MissouriMRDT/RemoteController_Hardware/Documentation/PDR/PDR_Controller_PCB.png

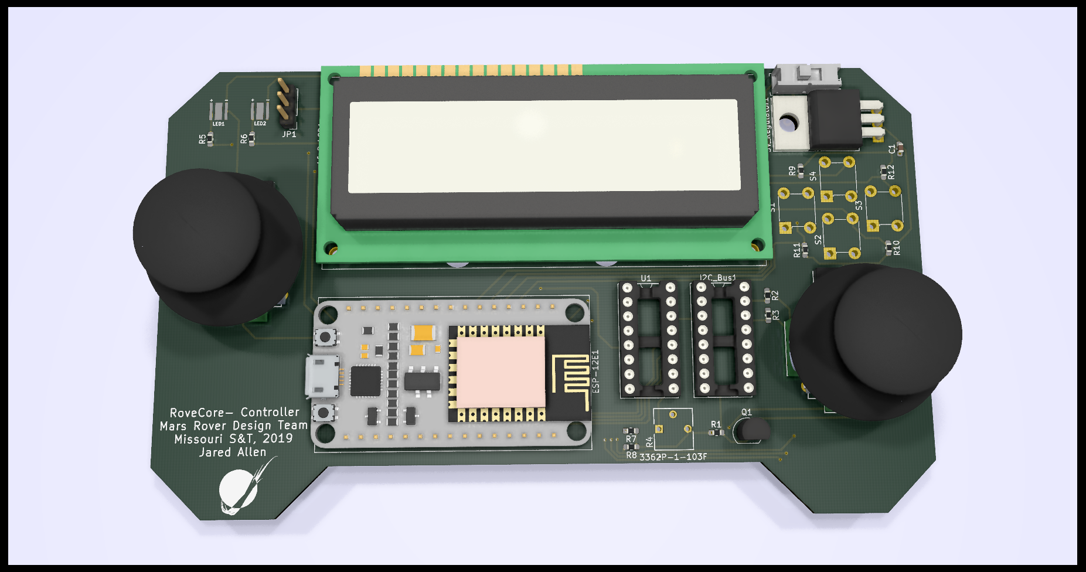
Documentation/PDR/PDR_Controller_PCB.png
