MissouriMRDT/RemoteController_Hardware/README.md

# RemoteController_Hardware
A Hardware Remote Control to drive the rover and perform other functions
