MissouriMRDT/RemoteController_Hardware/Documentation/PDR/PDR_Controller_Schematic.PNG

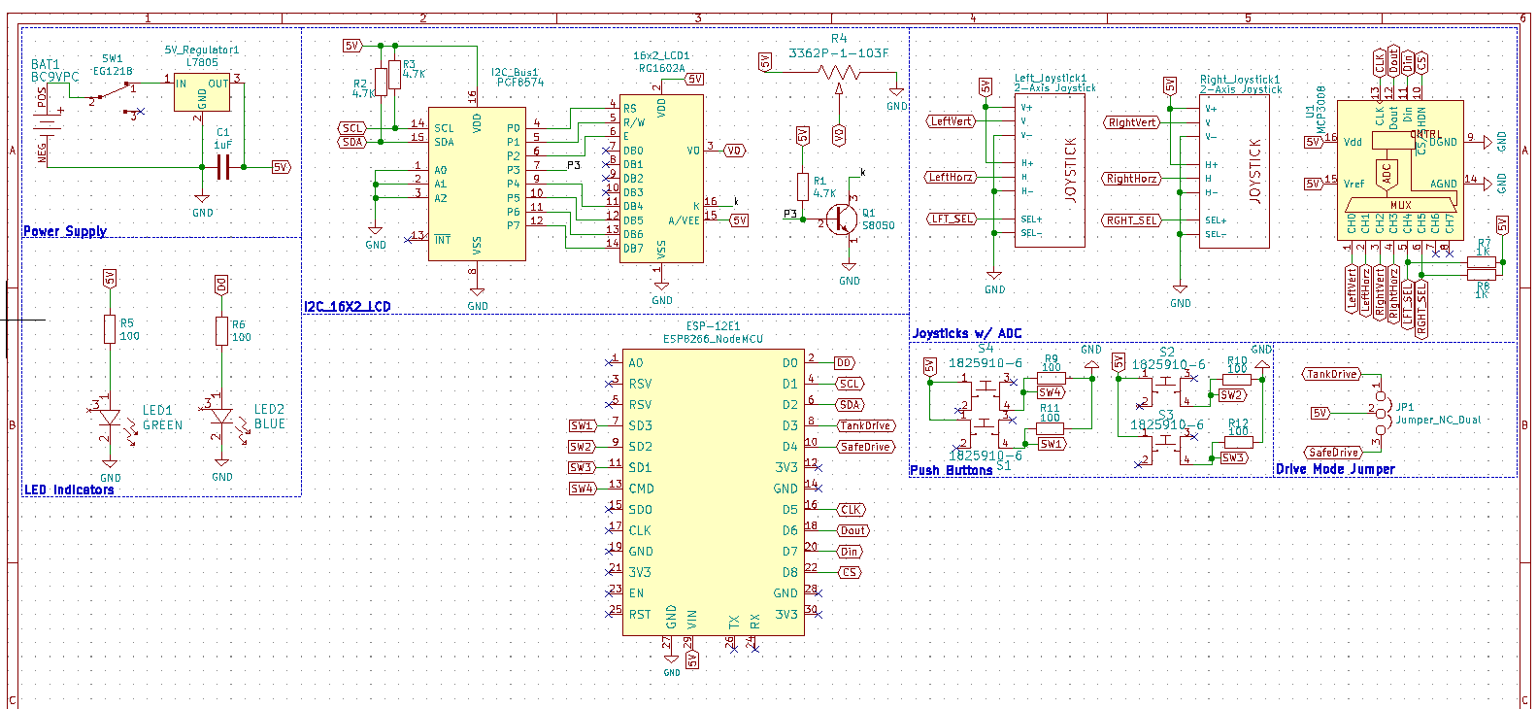
Documentation/PDR/PDR_Controller_Schematic.PNG
