MissouriMRDT/RemoteController_Hardware/Documentation/PDR/PDR_Controller_TraceView.PNG

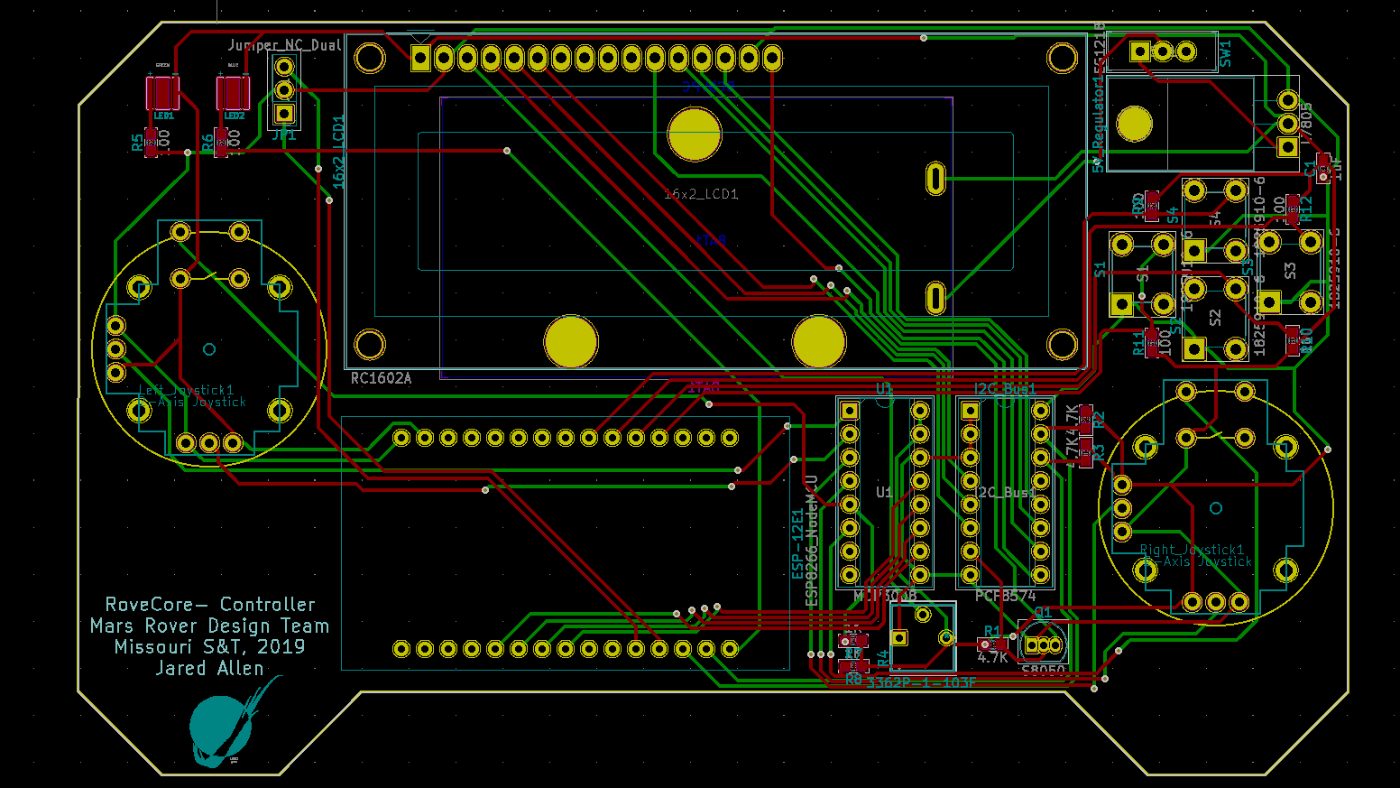
Documentation/PDR/PDR_Controller_TraceView.PNG
