MissouriMRDT/RemoteController_Hardware/Documentation/Signature_Jared_Allen.bmp

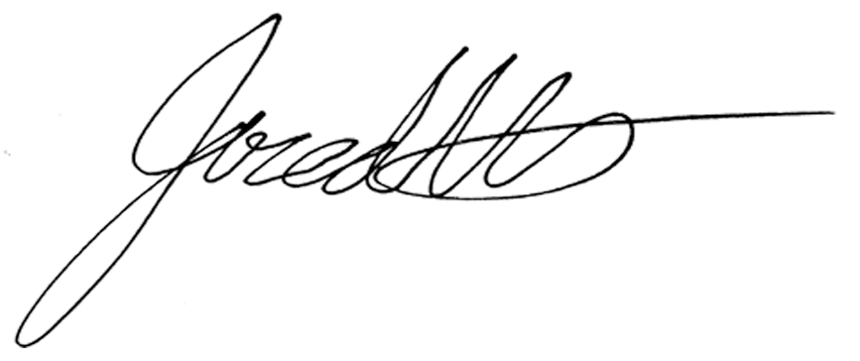
Documentation/Signature_Jared_Allen.bmp
