MissouriMRDT/RemoteController_Hardware/Rover_Controller/Rover_Controller_BOM.xlsx

Id | Designator | Package | Quantity | Designation | Item Name | Part Number | Vendor | Cost Per Item | Cost | URL | Comments | Quantity
1 | R10,R7,R8,R12,R11,R9,R13,R14 | R_0603_1608Metric_Pad1.05x0.95mm_HandSolder | 8 | 10K |  |  |  |  |  |  |  |  | Total Cost
2 | BT1 | Battery_Holder_9V_BC9VPC-ND | 1 | 9V_BAT |  |  |  |  |  |  |  |  | $0.000
3 | R6,R5,R4 | R_0603_1608Metric_Pad1.05x0.95mm_HandSolder | 3 | 510
4 | I2C_Bus1 | SOIC-16W_7.5x10.3mm_P1.27mm | 1 | PCF8574
5 | R1,R2,R3 | R_0603_1608Metric_Pad1.05x0.95mm_HandSolder | 3 | 4.7K
6 | C2,C1 | C_0603_1608Metric_Pad1.05x0.95mm_HandSolder | 2 | 1uF
7 | ADC1 | SOIC-16_3.9x9.9mm_P1.27mm | 1 | MCP3008
8 | COM1 | LED_0603_1608Metric_Pad1.05x0.95mm_HandSolder | 1 | BLUE
9 | TANK1 | LED_0603_1608Metric_Pad1.05x0.95mm_HandSolder | 1 | RED
10 | JP1 | PinHeader_1x03_P2.54mm_Vertical | 1 | Jumper_NC_Dual
11 | 16x2_LCD1 | WC1602A | 1 | RC1602A
12 | JOY2 | JOYSTICK | 1 | RIGHT_JOY
13 | Q1 | TO-92_Inline | 1 | S8050
14 | JOY1 | JOYSTICK | 1 | LEFT_JOY
15 | ESP-12E1 | ESP8266_nodeMCU | 1 | ESP8266_NodeMCU
16 | PWR1 | LED_0603_1608Metric_Pad1.05x0.95mm_HandSolder | 1 | GREEN
17 | RV1 | 3362P-1-103LF | 1 | R_POT_TRIM_10K
18 | SW1,SW2,SW3,SW4 | SW_SPST_TL3305A | 4 | SW_Push
19 | PWR_SW1 | SW_CuK_OS102011MA1QN1_SPDT_Angled | 1 | SW_SPDT
20 | 5V_Reg_1 | TO-252-2 | 1 | L7805
