MissouriMRDT/RemoteController_Hardware/Documentation/Rover_Controller_BOM.xlsx

Id | Designator | Package | Quantity | Designation | Item Name | Part Number | Vendor | Cost Per Item | Cost | URL | Comments | Quantity
1 | R10,R7,R8,R12,R11,R9,R13,R14 | R_0603_1608Metric_Pad1.05x0.95mm_HandSolder | 8 | 10K | ESR03EZPF1002 | RHM10KADCT-ND | Digikey | $0.130 | $1.040 | https://www.digikey.com/product-detail/en/rohm-semiconductor/ESR03EZPF1002/RHM10KADCT-ND/1983753 |  | 8 | Total Cost
2 | BT1 | Battery_Holder_9V_BC9VPC-ND | 1 | 9V_BAT | BC9VPC | BC9VPC-ND | Digikey | $1.980 | $1.980 | https://www.digikey.com/product-detail/en/mpd-memory-protection-devices/BC9VPC/BC9VPC-ND/257747 |  | 1 | $57.020
3 | R6,R5,R4 | R_0603_1608Metric_Pad1.05x0.95mm_HandSolder | 3 | 510 | ESR03EZPJ511 | RHM510DCT-ND | Digikey | $0.100 | $0.300 | https://www.digikey.com/product-detail/en/rohm-semiconductor/ESR03EZPJ511/RHM510DCT-ND/1762937 |  | 3
4 | I2C_Bus1 | SOIC-16W_7.5x10.3mm_P1.27mm | 1 | PCF8574 | PCF8574ADWR | 296-13105-1-ND | Digikey | $1.320 | $1.320 | https://www.digikey.com/product-detail/en/texas-instruments/PCF8574ADWR/296-13105-1-ND/484468 |  | 1
5 | R1,R2,R3 | R_0603_1608Metric_Pad1.05x0.95mm_HandSolder | 3 | 4.7K | ESR03EZPJ472 | RHM4.7KDCT-ND | Digkey | $0.100 | $0.300 | https://www.digikey.com/products/en?keywords=RHM4.7KDCT-ND |  | 3
6 | C2,C1 | C_0603_1608Metric_Pad1.05x0.95mm_HandSolder | 2 | 1uF | CL10B105MO8NNWC | 1276-6524-1-ND | Digikey | $0.100 | $0.200 | https://www.digikey.com/product-detail/en/samsung-electro-mechanics/CL10B105MO8NNWC/1276-6524-1-ND/5961383 |  | 2
7 | ADC1 | SOIC-16_3.9x9.9mm_P1.27mm | 1 | MCP3008 | MCP3008-I/SL | MCP3008-I/SL-ND | Digikey | $2.190 | $2.190 | https://www.digikey.com/product-detail/en/microchip-technology/MCP3008-I-SL/MCP3008-I-SL-ND/319423 |  | 1
8 | COM1 | LED_0603_1608Metric_Pad1.05x0.95mm_HandSolder | 1 | BLUE | LTST-C191TBKT | 160-1647-1-ND | Digikey | $0.500 | $0.500 | https://www.digikey.com/product-detail/en/lite-on-inc/LTST-C191TBKT/160-1647-1-ND/573587 |  | 1
9 | TANK1 | LED_0603_1608Metric_Pad1.05x0.95mm_HandSolder | 1 | RED | LTST-C19KRKT | 160-1447-1-ND | Digikey | $0.280 | $0.280 | https://www.digikey.com/product-detail/en/lite-on-inc/LTST-C191KRKT/160-1447-1-ND/386836 |  | 1
10 | JP1 | PinHeader_1x03_P2.54mm_Vertical | 1 | Jumper_NC_Dual | 61300311121 | 732-5316-ND | Digikey | $0.130 | $0.130 | https://www.digikey.com/product-detail/en/w-rth-elektronik/61300311121/732-5316-ND/4846825 |  | 1
11 | 16x2_LCD1 | WC1602A | 1 | RC1602A | LCR-U01602DSF/AWH | 67-2091-ND | Digikey | $18.510 | $18.510 | https://www.digikey.com/product-detail/en/lumex-opto-components-inc/LCR-U01602DSF-AWH/67-2091-ND/2237961 |  | 1
12 | JOY2 | JOYSTICK | 1 | RIGHT_JOY | COM-09032 | 1568-1526-ND | Digikey | $3.950 | $3.950 | https://www.digikey.com/product-detail/en/sparkfun-electronics/COM-09032/1568-1526-ND/6823623 |  | 1
13 | Q1 | TO-92_Inline | 1 | S8050 | SS8050DTA | SS8050DTACT-ND | Digikey | $0.280 | $0.280 | https://www.digikey.com/product-detail/en/on-semiconductor/SS8050DTA/SS8050DTACT-ND/4213850 |  | 1
14 | JOY1 | JOYSTICK | 1 | LEFT_JOY | COM-09032 | 1568-1526-ND | Digikey | $3.950 | $3.950 | https://www.digikey.com/product-detail/en/sparkfun-electronics/COM-09032/1568-1526-ND/6823623 |  | 1
15 | ESP-12E1 | ESP8266_nodeMCU | 1 | ESP8266_NodeMCU | 3046 | 1528-1901-ND | Digikey | $18.950 | $18.950 | https://www.digikey.com/product-detail/en/adafruit-industries-llc/3046/1528-1901-ND/6674211 |  | 1
16 | PWR1 | LED_0603_1608Metric_Pad1.05x0.95mm_HandSolder | 1 | GREEN | LTST-C191KGKT | 160-1446-1-ND | Digikey | $0.280 | $0.280 | https://www.digikey.com/product-detail/en/lite-on-inc/LTST-C191KGKT/160-1446-1-ND/386834 |  | 1
17 | RV1 | 3362P-1-103LF | 1 | R_POT_TRIM_10K | 3362P-1-103LF | 3362P-103LF-ND | Digikey | $1.020 | $1.020 | https://www.digikey.com/products/en?keywords=3362p-1-103LF |  | 1
18 | SW1,SW2,SW3,SW4 | SW_SPST_TL3305A | 4 | SW_Push | TL3305AF160QG | EG5350CT-ND | Digikey | $0.200 | $0.800 | https://www.digikey.com/product-detail/en/e-switch/TL3305AF160QG/EG5350CT-ND/5816195 |  | 4
19 | PWR_SW1 | SW_CuK_OS102011MA1QN1_SPDT_Angled | 1 | SW_SPDT | Os102011MA1QN1 | CKN9559-ND | Digikey | $0.380 | $0.380 | https://www.digikey.com/products/en?keywords=CKN9559-ND |  | 1
20 | 5V_Reg_1 | TO-252-2 | 1 | L7805 | L7805ABD2T-TR | 497-1170-1-ND | Digikey | $0.660 | $0.660 | https://www.digikey.com/product-detail/en/stmicroelectronics/L7805ABD2T-TR/497-1170-1-ND/586170 |  | 1
