MissouriMRDT/RemoteController_Hardware/Rover_Controller/Rover_Controller 3D Models/PZ_PushButton.stp

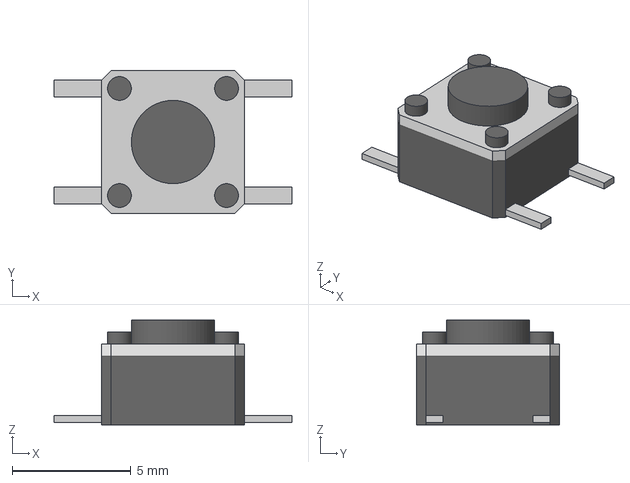
[picture p6: CAD file, 2019-12-11]
Rover_Controller/Rover_Controller 3D Models/PZ_PushButton.stp
10.0 x 6.00 x 4.40 mm
