MissouriMRDT/RemoteController_Hardware/Rover_Controller/Rover_Controller 3D Models/BC9VPC.STEP

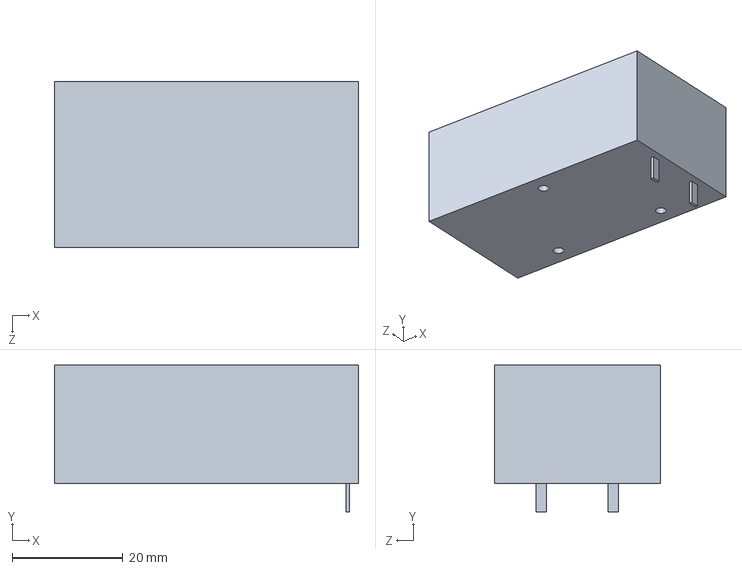
[picture p7: CAD file, 2019-10-12]
Rover_Controller/Rover_Controller 3D Models/BC9VPC.STEP
54.9 x 26.5 x 30.0 mm
