MissouriMRDT/RemoteController_Hardware/Rover_Controller/Rover_Controller 3D Models/EG1218.stp

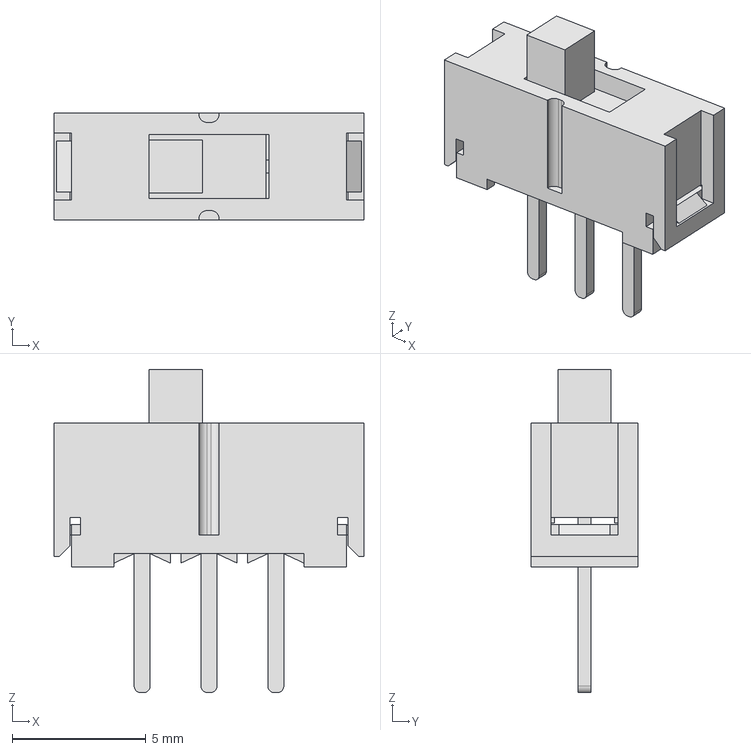
[picture p8: CAD file, 2019-10-12]
Rover_Controller/Rover_Controller 3D Models/EG1218.stp
11.6 x 4.00 x 12.1 mm
