MissouriMRDT/RemoteController_Hardware/Rover_Controller/Rover_Controller 3D Models/Joystick.STEP

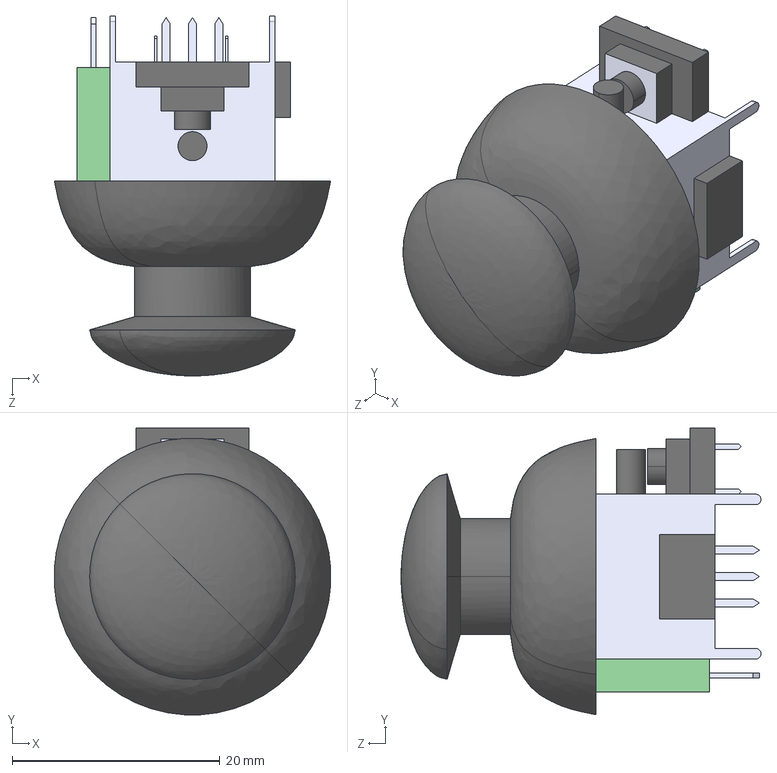
[picture p10: CAD file, 2019-10-12]
Rover_Controller/Rover_Controller 3D Models/Joystick.STEP
26.6 x 27.6 x 34.7 mm
