MissouriMRDT/RemoteController_Hardware/(list of files, cad)

Other CAD files:
Rover_Controller/Rover_Controller Outline/Controller_Outline.dwg
