MissouriMRDT/RemoteController_Hardware/Rover_Controller/Rover_Controller.kicad_pcb

## KiCad design Rover_Controller/Rover_Controller.kicad_pcb (2019-12-11)

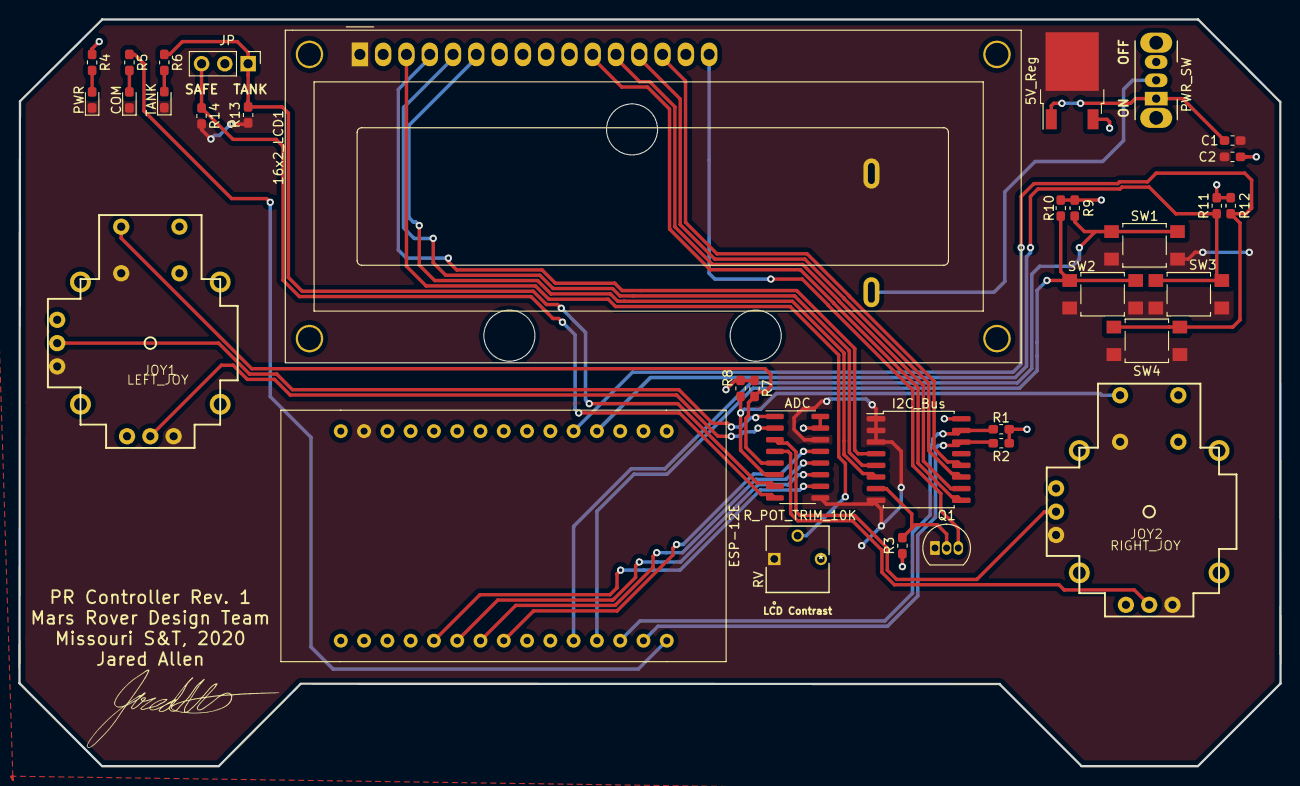
[picture p11: board Rover_Controller.kicad_pcb from above]

Board: 2 copper layers, 137.6 x 81.5 mm, 35 parts (1 on the bottom side), 36 nets.

Parts:
5V_Reg: L7805; TO-252-2
16x2_LCD1: RC1602A; WC1602A
ADC: MCP3008; SOIC-16_3.9x9.9mm_P1.27mm
BT1: 9V_BAT; Battery_Holder_9V_BC9VPC-ND
C1, C2: 1uF; C_0603_1608Metric_Pad1.05x0.95mm_HandSolder
COM: BLUE; LED_0603_1608Metric_Pad1.05x0.95mm_HandSolder
ESP-12E: ESP8266_NodeMCU; ESP8266_nodeMCU
I2C_Bus: PCF8574; SOIC-16W_7.5x10.3mm_P1.27mm
JOY1: LEFT_JOY; JOYSTICK
JOY2: RIGHT_JOY; JOYSTICK
JP: Jumper_NC_Dual; PinHeader_1x03_P2.54mm_Vertical
PWR: GREEN; LED_0603_1608Metric_Pad1.05x0.95mm_HandSolder
PWR_SW: SW_SPDT; SW_CuK_OS102011MA1QN1_SPDT_Angled
Q1: S8050; TO-92_Inline
R1, R2, R3: 4.7K; R_0603_1608Metric_Pad1.05x0.95mm_HandSolder
R4, R5, R6: 510; R_0603_1608Metric_Pad1.05x0.95mm_HandSolder
R7, R8, R9, R10, R11, R12, R13, R14: 10K; R_0603_1608Metric_Pad1.05x0.95mm_HandSolder
RV: R_POT_TRIM_10K; 3362P-1-103LF
SW1, SW2, SW3, SW4: SW_Push; SW_SPST_TL3305A
TANK: RED; LED_0603_1608Metric_Pad1.05x0.95mm_HandSolder

Connections:
+5V: 5V_Reg.3, 16x2_LCD1.2, 16x2_LCD1.15, ADC.15, ADC.16, C2.1, ESP-12E.29, I2C_Bus.16, JOY1.H1, JOY1.V1, JOY2.H1, JOY2.V1, JP.2, R1.1, R2.1, R3.1, R4.1, R7.1, R8.1, R9.2, R10.2, R11.2, R12.2, RV.3
CLK: ADC.13, ESP-12E.16
CS: ADC.10, ESP-12E.22
D0: ESP-12E.2, R5.1
Din: ADC.11, ESP-12E.20
Dout: ADC.12, ESP-12E.18
GND: 5V_Reg.2, 16x2_LCD1.1, ADC.9, ADC.14, BT1.2, C1.2, C2.2, COM.1, ESP-12E.27, I2C_Bus.1, I2C_Bus.2, I2C_Bus.3, I2C_Bus.8, JOY1.B2A, JOY1.H3, JOY1.V3, JOY2.B2A, JOY2.H3, JOY2.V3, PWR.1, Q1.1, R13.1, R14.2, RV.1, SW1.2, SW2.2, SW3.2, SW4.2, TANK.1
LeftHorz: ADC.2, JOY1.H2
LeftSel: ADC.5, JOY1.B1A, R7.2
LeftVert: ADC.1, JOY1.V2
unnamed: 5V_Reg.1, C1.1, PWR_SW.1
unnamed: 16x2_LCD1.4, I2C_Bus.4
unnamed: 16x2_LCD1.5, I2C_Bus.5
unnamed: 16x2_LCD1.6, I2C_Bus.6
unnamed: 16x2_LCD1.11, I2C_Bus.9
unnamed: 16x2_LCD1.12, I2C_Bus.10
unnamed: 16x2_LCD1.13, I2C_Bus.11
unnamed: 16x2_LCD1.14, I2C_Bus.12
unnamed: BT1.1, PWR_SW.2
unnamed: COM.2, R5.2
unnamed: PWR.2, R4.2
unnamed: R6.2, TANK.2
P3: I2C_Bus.7, Q1.2, R3.2
RightHorz: ADC.4, JOY2.H2
RightSel: ADC.6, JOY2.B1A, R8.2
RightVert: ADC.3, JOY2.V2
SCL: ESP-12E.4, I2C_Bus.14, R2.2
SDA: ESP-12E.6, I2C_Bus.15, R1.2
SW1: ESP-12E.10, R9.1, SW1.1
SW2: ESP-12E.8, R10.1, SW2.1
SW3: ESP-12E.7, R11.1, SW3.1
SW4: ESP-12E.9, R12.1, SW4.1
SafeDrive: ADC.8, JP.3, R14.1
TankDrive: ADC.7, JP.1, R6.1, R13.2
V0: 16x2_LCD1.3, RV.2
k: 16x2_LCD1.16, Q1.3
