MissouriMRDT/RemoteController_Hardware/(commit log)

2019-09-21 Initial Schematic Files
    Initial KiCAD schematic with power power supply. 9V battery input voltage regulated down to 5v.
    [Controller Board.kicad_pcb, Controller Board.sch]
2019-09-21 Initial Schematic Files and Documentation
    New schematic file that only contains power supply, and initial documentation of project.
    [Controller Board.kicad_pcb, Controller Board.sch]
2019-09-22 Started ESP-nodeMCU footprint
    [Controller Board.sch]
2019-09-22 Footprint Drawing Completed
    Footprint and pads are correctly placed and outline. The pads do not correspond correctly to the esp in the schematic.
2019-09-28 MCU block edited, i2c and lcd added
    [Controller Board.sch]
2019-09-28 I2C and LCD connections
    [Controller Board.sch]
2019-09-28 Documentation Updated
    [Controller Board.sch]
2019-09-28 I2C to LCD Initial Completion
    [Controller Board.sch]
2019-09-28 I2C to LCD Connection Updated
    [Controller Board.sch]
2019-09-28 Joystick Symbol Created
    NodeMCU symbol updated
    [Controller Board.sch]
2019-09-28 Joystick Library Imported
    [Controller Board.sch]
2019-09-28 Joystick Schematic Placement
    Changed joystick placement and provided power.
    [Controller Board.sch]
2019-10-03 Joystick Wires Placed
    [Controller Board.sch]
2019-10-03 Reorganization of Joystick Library
    No change to circuit design or PCB
    [Controller Board.sch]
2019-10-05 Started Joystick Connections to ESP
    [Controller Board.sch]
2019-10-05 Multiplexer Connected to Joysticks
    Temporary design where joysticks are connected to ESP using 4051 Multiplexer
    [Controller Board.sch]
2019-10-05 Replaced Multiplexer with ADC
    MCP3008 10-bit ADC connected with Joysticks and ESP. All Critical components are added to the schematic at this time.
    [Controller Board.sch]
2019-10-08 Jumper Added
    [Controller Board.sch]
2019-10-08 I2C Bus Footprint Created
    Additional footprints added
    [Controller Board.sch]
2019-10-08 Updated all major Footprints
    [Controller Board.sch]
2019-10-08 Potentiometer Changed
    Changed potentiometer to footprint from Bourns EDA library. 10Kohm potentiometer added.
    [Controller Board.sch]
2019-10-08 Footprints Aded
    Footprints for all current components have been added, began work on the PCB.
    [Controller Board.kicad_pcb, Controller Board.sch]
2019-10-08 LED Indicators Added
    Power LED indicator, and connectivity LED indicator added.
    [Controller Board.kicad_pcb, Controller Board.sch]
2019-10-09 Updated Footprints
    [Controller Board.sch]
2019-10-09 Updated ESP Footprint
2019-10-09 Schematic Placement Changes
    [Controller Board.sch]
2019-10-09 Footprint Repaird for ESP
    Due to changes in file placement for ESP, the symbol needed to be updated in order to work with the footprint.
    [Controller Board.sch]
2019-10-09 PCB Design Started
    Created Controller outline in AutoCAD, placed most components on the board.
    [Controller Board.kicad_pcb, Controller_Outline.dwg, Controller_Outline.dxf]
2019-10-10 Fixed Empty Pins
    Corrected areas of the schematic for pins that have no use
    [Controller Board.sch]
2019-10-10 Added Pull-Up Resistors to ADC
    [Controller Board.kicad_pcb, Controller Board.sch]
2019-10-10 Updated Layout of PCB
    [Controller Board.kicad_pcb]
2019-10-10 Added 4 THT PushButtons
    [Controller Board.sch]
2019-10-10 9v Battery Holder Added
    [Controller Board.kicad_pcb, Controller Board.sch]
2019-10-10 Updated Net, and Started PCB Traces
    [Controller Board.kicad_pcb, Controller Board.sch]
2019-10-10 PCB Traces Updated
    Traces connected to right joystick and pushbuttons
    [Controller Board.kicad_pcb, Controller Board.sch]
2019-10-10 Trace Update
    [Controller Board.kicad_pcb, Controller Board.sch]
2019-10-11 PCB Traces Updated
    [Controller Board.kicad_pcb, Controller Board.sch]
2019-10-11 PCB Updated
    [Controller Board.kicad_pcb]
2019-10-11 PCB Updated, Power Switch Added
    [Controller Board.kicad_pcb]
2019-10-11 I2C Traces Placed
    [Controller Board.kicad_pcb, Controller Board.sch]
2019-10-11 All I2C Traces Placed
    [Controller Board.kicad_pcb]
2019-10-11 PCB Updated
    Team Lead approved design at this point.
    [Controller Board.kicad_pcb, Controller Board.sch]
2019-10-12 All PCB Traces Placed
    [Controller Board.kicad_pcb]
2019-10-12 3D Models added to components
    [Controller Board.kicad_pcb, Controller Board.sch, ESP8266 v7.stp, Joystick.STEP]
2019-10-12 3D Components Finalized
    PDR ready at this point
    [BC9VPC.STEP, Controller Board.kicad_pcb, EG1218.stp]
2019-10-12 MRDT Silkscreen added
    [Controller Board.kicad_pcb]
2019-10-12 Silkscreen Updated with MRDT Logo
    [Controller Board.kicad_pcb]
2019-10-18 Symbol Updates
    [Controller Board.kicad_pcb, Controller Board.sch]
2019-11-03 Capactiro Added to Input of 7805
    [Controller Board.sch]
2019-11-03 Silkscreen Updated
    Capactior connections made with new capactior at input of 7805, and silkscreen updated.
    [Controller Board.kicad_pcb, Controller Board.sch]
2019-11-03 Silkscreen Updated
    [Controller Board.kicad_pcb]
2019-11-03 7805 Input Capacitor Updated
    [Controller Board.kicad_pcb, Controller Board.sch]
2019-11-03 Netlist Updated
    [Controller Board.kicad_pcb, Controller Board.sch]
2019-11-03 Silkscreen Updated for LEDs
    [Controller Board.kicad_pcb, Controller Board.sch]
2019-11-05 Revision 2 Files Added
    [Controller Board.kicad_pcb, Controller Board.sch]
2019-11-05 All Push-Buttons Re-Mapped
    Buttons 3 & 4 had to be re-mapped through the ADC due to compatability issues with the original pins they were connected to. All schematic and PCB changes have been made. Buttons 1 & 2 also needed to be re-mapped to account for the change, but are still connected to the ESP
    [Controller Board.kicad_pcb, Controller Board.sch]
2019-11-05 Button Resistor Connections Changed
    Re-configuration to resistors connected to push buttons. Changes made for both schematic and PCB. All new traces placed.
    [Controller Board.kicad_pcb, Controller Board.sch]
2019-11-06 Test Code Modifications
    [Controller Board.kicad_pcb]
2019-11-07 removed duplicated files
    [Controller Board.kicad_pcb, Controller Board.sch]
2019-11-07 Button Layout Changed
    Drive control jumper and button layout has changed due to testing errors found. The jumper will now run through the ADC, whereas all 4 buttons will all run through the ESP directly. This version does not include changes to PCB
    [Controller Board.sch]
2019-11-07 Push Button and Jumper PCB Traces Updated
    [Controller Board.kicad_pcb, Controller Board.sch]
2019-11-07 PushButtons Tied-HIGH
    [Controller Board.sch]
2019-11-07 New Button Traces Placed
    [Controller Board.kicad_pcb, Controller Board.sch]
2019-11-10 3D Files Updated
    [Controller Board.kicad_pcb]
2019-11-10 Trace corners re-adjusted
    [Controller Board.kicad_pcb]
2019-11-11 Repository Re-Organized
    [BC9VPC.STEP, Controller Board.kicad_pcb, Controller Board.sch, Controller_Outline.dwg, Controller_Outline.dxf, EG1218.stp, ESP8266 v7.stp, Joystick.STEP]
2019-11-11 Power Regulator and LEDs re-configured
    Power regulator and LEDs for power and COM indication have been re-done in the shematic on the 50mil grid size
    [Controller Board.sch]
2019-11-11 Create Board Review Notes.txt
2019-11-11 LCD Schematic re-configured
    re-configured to fit 50mil grid
    [Controller Board.sch]
2019-11-11 Footprints Given in Power Supply/LCD
    [Controller Board.sch]
2019-11-12 ADC Re-Mapped on Schematic
    [Controller Board.sch]
2019-11-12 Push Buttons Re-Mapped and Changed to 2-Pin SPST
    [Controller Board.sch]
2019-11-12 Schematic Re-Done on 50mil Grid
    The entire schematic has been re-formatted on a 50mil grid, along with a few other changes as outlined in the Documentation file "Board Review Notes"
    [Controller Board.sch]
2019-11-14 re-mapped joysticks
    [Controller Board.sch]
2019-11-14 PCF and MCP Switched to SMD
    [Controller Board.sch]
2019-11-14 File Name Change
    [Rover_Controller.kicad_pcb, Rover_Controller.sch]
2019-11-14 MCP3008 SMD Footprint Applied
2019-11-16 Footrpints Updated
    [Rover_Controller.sch]
2019-11-16 PCB Netlist Updated
    [Rover_Controller.sch]
2019-11-19 Traces Removed From PCB
    Traces were removed so that re-tracing could be done. With a few new SMD components and enhanced component placement re-tracing the whole board was deemed appropriate.
    [Rover_Controller.kicad_pcb]
2019-11-19 Display Association Changed
    [Rover_Controller.sch]
2019-11-19 Components Re-Configured on PCB
    [Rover_Controller.kicad_pcb, Rover_Controller.sch]
2019-11-28 PCB Components Re-Alligned
    [Rover_Controller.kicad_pcb, Rover_Controller.sch]
2019-12-03 Traces Updated
    [Rover_Controller.kicad_pcb, Rover_Controller.sch]
2019-12-03 I2C Bus Traces Completed
    [Rover_Controller.kicad_pcb]
2019-12-04 All Traces Placed
    [Rover_Controller.kicad_pcb]
2019-12-04 Datasheets Added
    [Rover_Controller.sch]
2019-12-05 Re-Traced Long Diagonal Traces
    [Rover_Controller.kicad_pcb]
2019-12-05 Button Footprints Updated
    [Rover_Controller.kicad_pcb, Rover_Controller.sch]
2019-12-10 5V PCB Trace Pads Updated
    [Rover_Controller.kicad_pcb, Rover_Controller.sch]
2019-12-10 Slide Switch Changed to Angled Switch
    [Rover_Controller.kicad_pcb, Rover_Controller.sch]
2019-12-10 Schematic Updated for Switch
    [Rover_Controller.sch]
2019-12-10 7805 Package Updated
    [Rover_Controller.kicad_pcb, Rover_Controller.sch]
2019-12-10 BOM Added
    [Rover_Controller_BOM.xlsx]
2019-12-11 BOM Updated
    [Rover_Controller_BOM.xlsx]
2019-12-11 BOM and Signature Updated
    [Rover_Controller.kicad_pcb, Rover_Controller.sch, Rover_Controller_BOM.xlsx]
2019-12-11 Signature File Location Changed
    [Rover_Controller.kicad_pcb]
2019-12-11 Libraries Updated & PCB Silkscreen Updated
    [Rover_Controller-B_Cu.gbr, Rover_Controller-B_Mask.gbr, Rover_Controller-B_Paste.gbr, Rover_Controller-B_SilkS.gbr, Rover_Controller-Edge_Cuts.gbr, Rover_Controller-F_Cu.gbr, Rover_Controller-F_Mask.gbr, Rover_Controller-F_Paste.gbr]
2019-12-11 ESP Library Updated
    [Rover_Controller.sch]
2019-12-11 3D Models Added
    [PZ_PushButton.stp, Rover_Controller.kicad_pcb]
2020-01-26 ESP12 Documentation Added
    [Rover_Controller_BOM.xlsx]
2020-01-27 Main Code Updated
    Included screen test to display joystick ADC values on LCD after startup
